MadhuhritaSaha/Freshy-for-ENose/DOCS/sample_chamber_3D.pdf

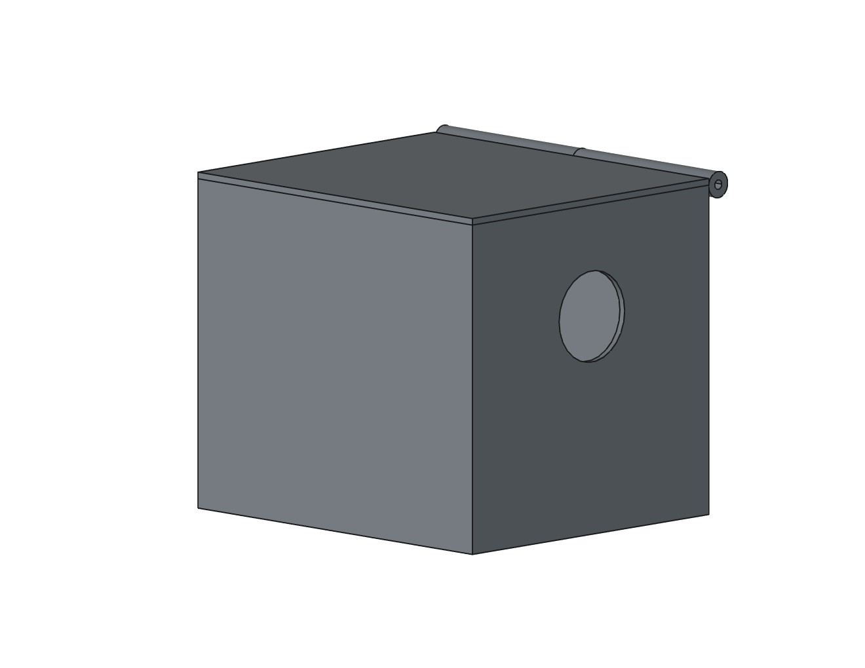
[picture p24: page 1]
