MadhuhritaSaha/Freshy-for-ENose/DOCS/sensor_chamber_3D.pdf

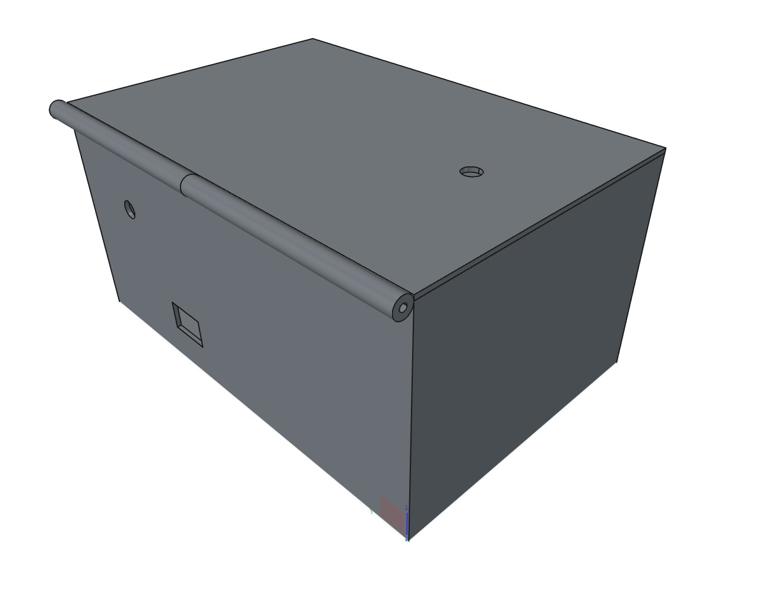
[picture p25: page 1]
