MadhuhritaSaha/Freshy-for-ENose/DOCS/Schematic 2.pdf

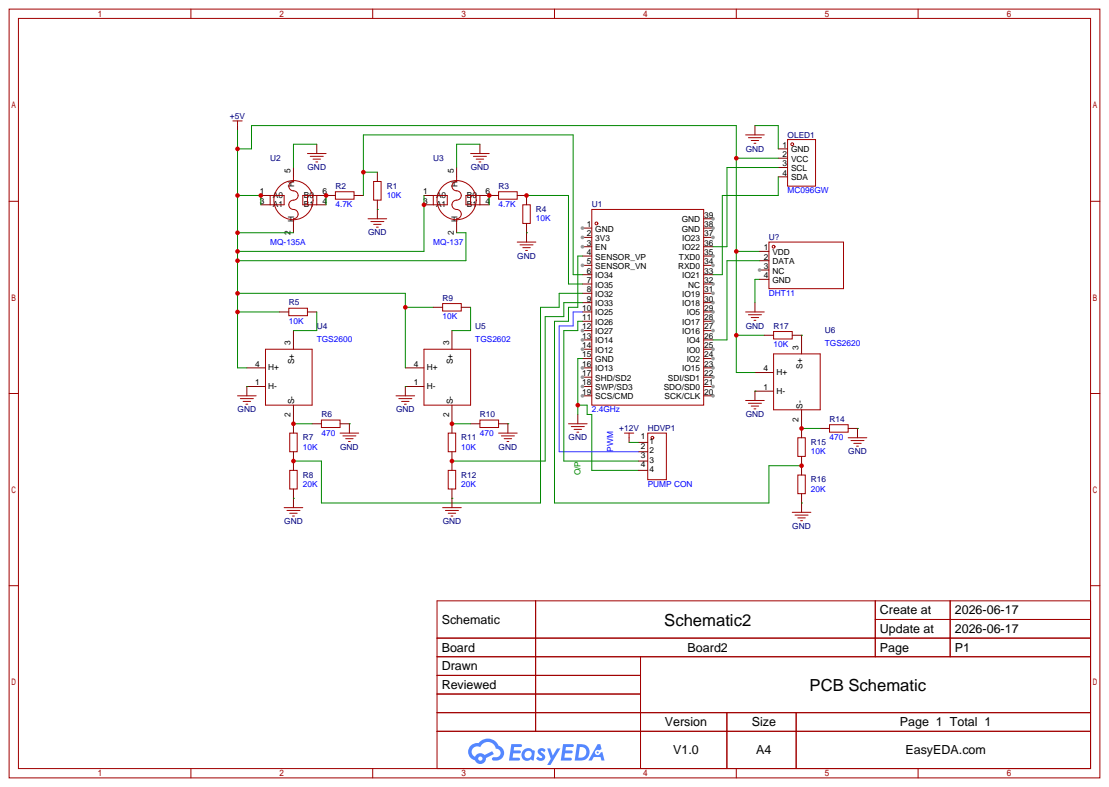
[picture p26: page 1]

Schematic | Schematic2 | Create at | 2026-06-17

Update at | 2026-06-17

Board | Board2 | Page | P1
Drawn | | PCB Schematic
Reviewed

Version | Size | Page 1 Total 1
V1.0 | A4 | EasyEDA.com
