MadhuhritaSaha/Freshy-for-ENose/DOCS/Workflow2.drawio.pdf

# Onion Freshness Classification

## ESP32-Based Electronic Nose for Multi-Class Onion Freshness

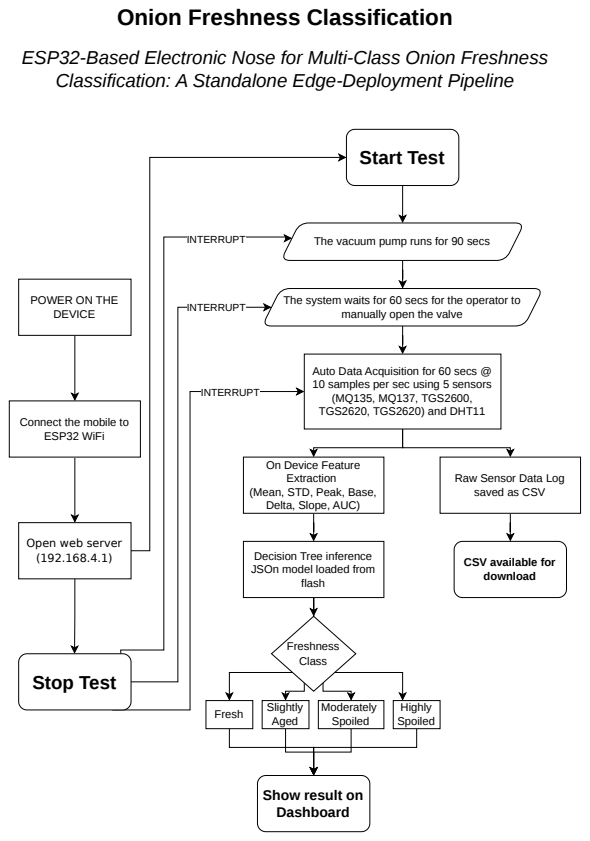
[picture p27: page 1]
Start Test; flash; Freshness Class; Moderately Spoiled; Slightly; Aged Fresh; Highly; Spoiled; INTERRUPT; Stop Test

Classification: A Standalone Edge-Deployment Pipeline

The vacuum pump runs for 90 secs

POWER ON THE
DEVICE

The system waits for 60 secs for the operator to

manually open the valve

Auto Data Acquisition for 60 secs @
10 samples per sec using 5 sensors
(MQ135, MQ137, TGS2600,
TGS2620, TGS2620) and DHT11

Connect the mobile to
ESP32 WiFi

On Device Feature
Extraction
(Mean, STD, Peak, Base,
Delta, Slope, AUC)

Raw Sensor Data Log
saved as CSV

Open web server

Decision Tree inference
JSOn model loaded from

CSV available for
download

Show result on
Dashboard
